ayush130305/8-Channel-PWM-Controller-with-SPI-Interface/pnr/pwm8_spi_core/pins.txt

miso_pn     S   250.70 (frame   950.70)
clk         S   508.80 (frame  1208.80)
sync_pn     S   800.70 (frame  1500.70)
rst_n       S  1058.80 (frame  1758.80)
sclk        S  1883.80 (frame  2583.80)
cs_n        S  2708.80 (frame  3408.80)
mosi        S  3258.80 (frame  3958.80)
pwm_pn[7]   N  1625.70 (frame  2325.70)
pwm_pn[6]   N  2175.70 (frame  2875.70)
pwm_pn[5]   N  3000.70 (frame  3700.70)
pwm_pn[0]   E   550.70 (frame  1250.70)
pwm_pn[1]   E  1075.70 (frame  1775.70)
pwm_pn[2]   E  1900.70 (frame  2600.70)
pwm_pn[3]   E  2725.70 (frame  3425.70)
pwm_pn[4]   E  3275.70 (frame  3975.70)
