ayush130305/8-Channel-PWM-Controller-with-SPI-Interface/docs/pwm8_spi.png

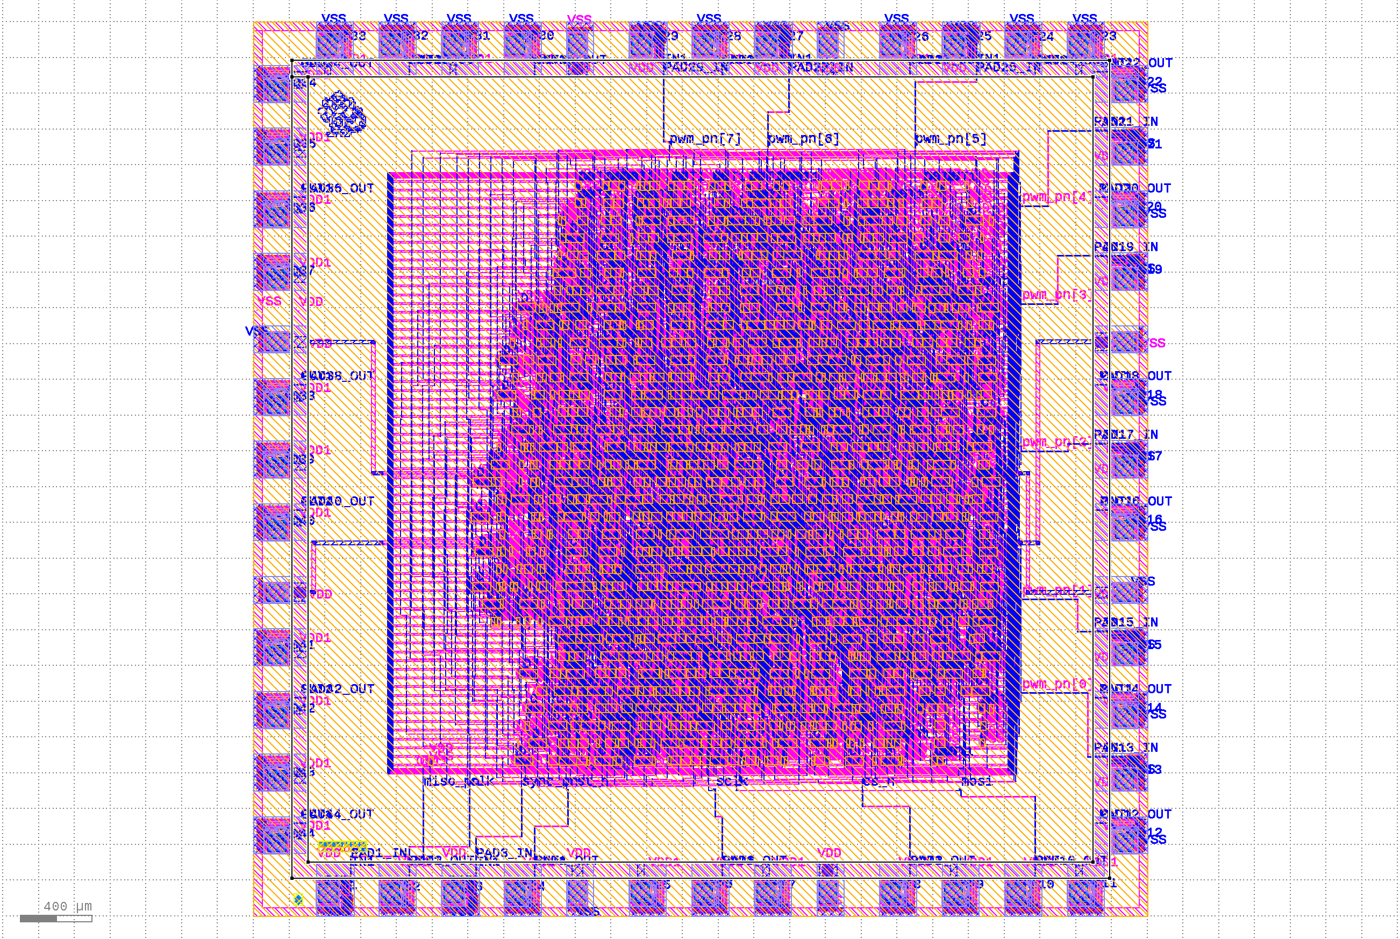
docs/pwm8_spi.png
