ayush130305/8-Channel-PWM-Controller-with-SPI-Interface/images/3_hierarchy/pwm8_spi_top.png

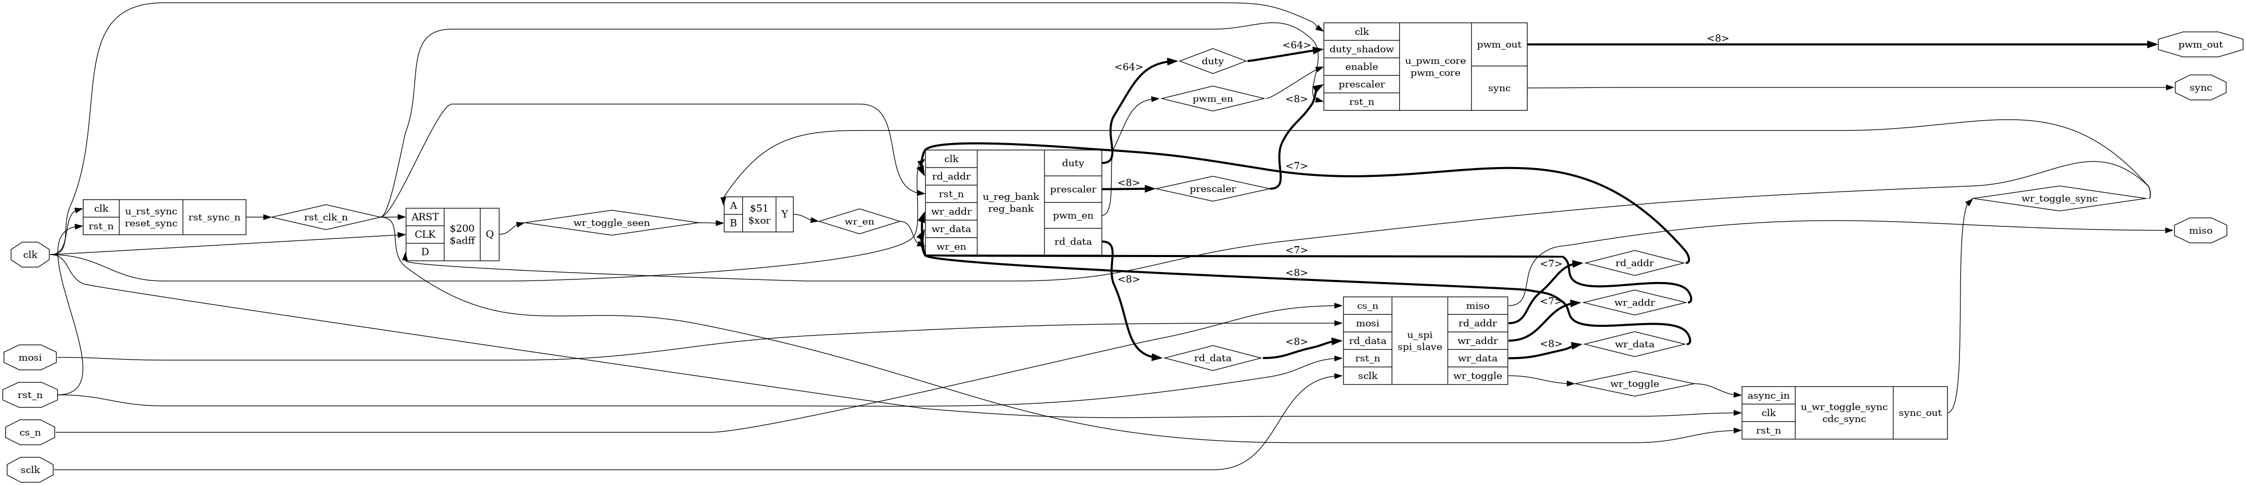
images/3_hierarchy/pwm8_spi_top.png
