ayush130305/8-Channel-PWM-Controller-with-SPI-Interface/images/4_rtl/pwm_core.png

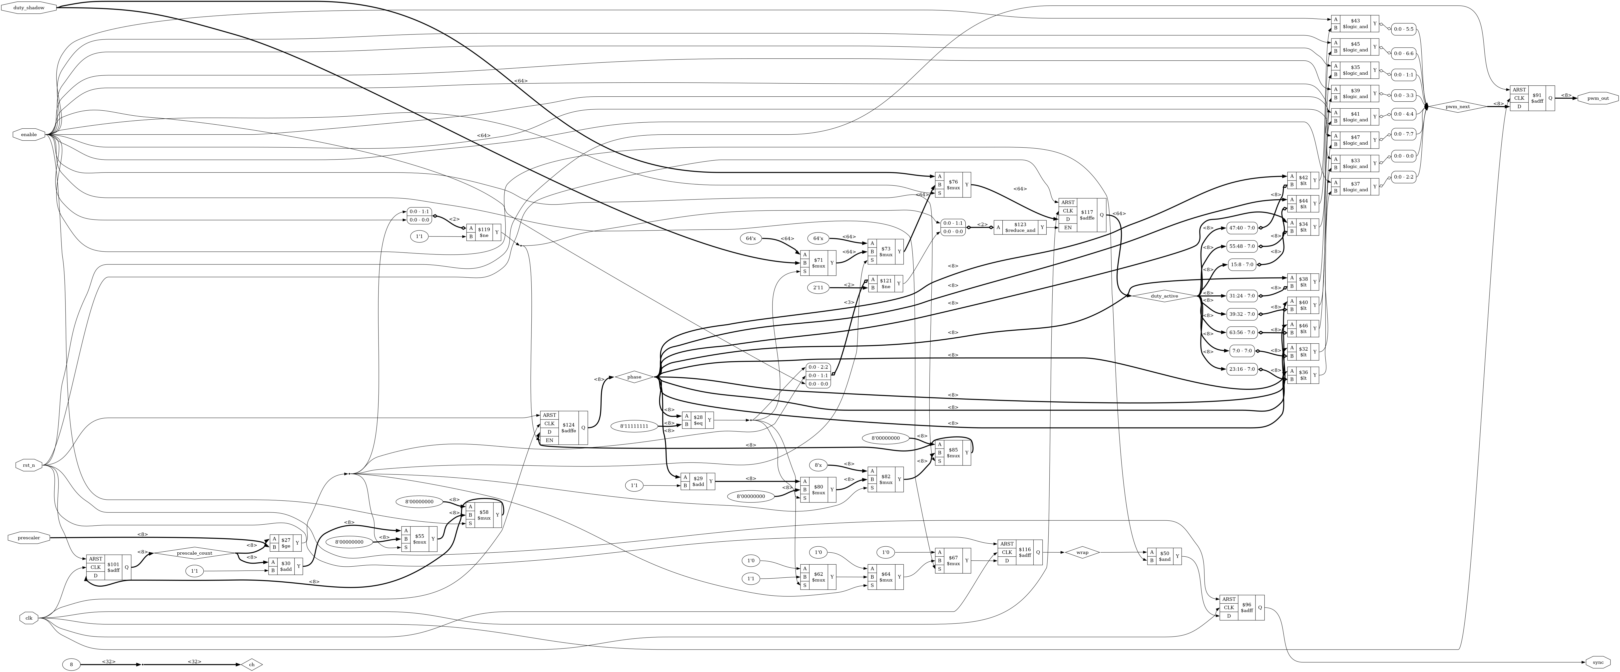
images/4_rtl/pwm_core.png
