ayush130305/8-Channel-PWM-Controller-with-SPI-Interface/images/4_rtl/reg_bank.png

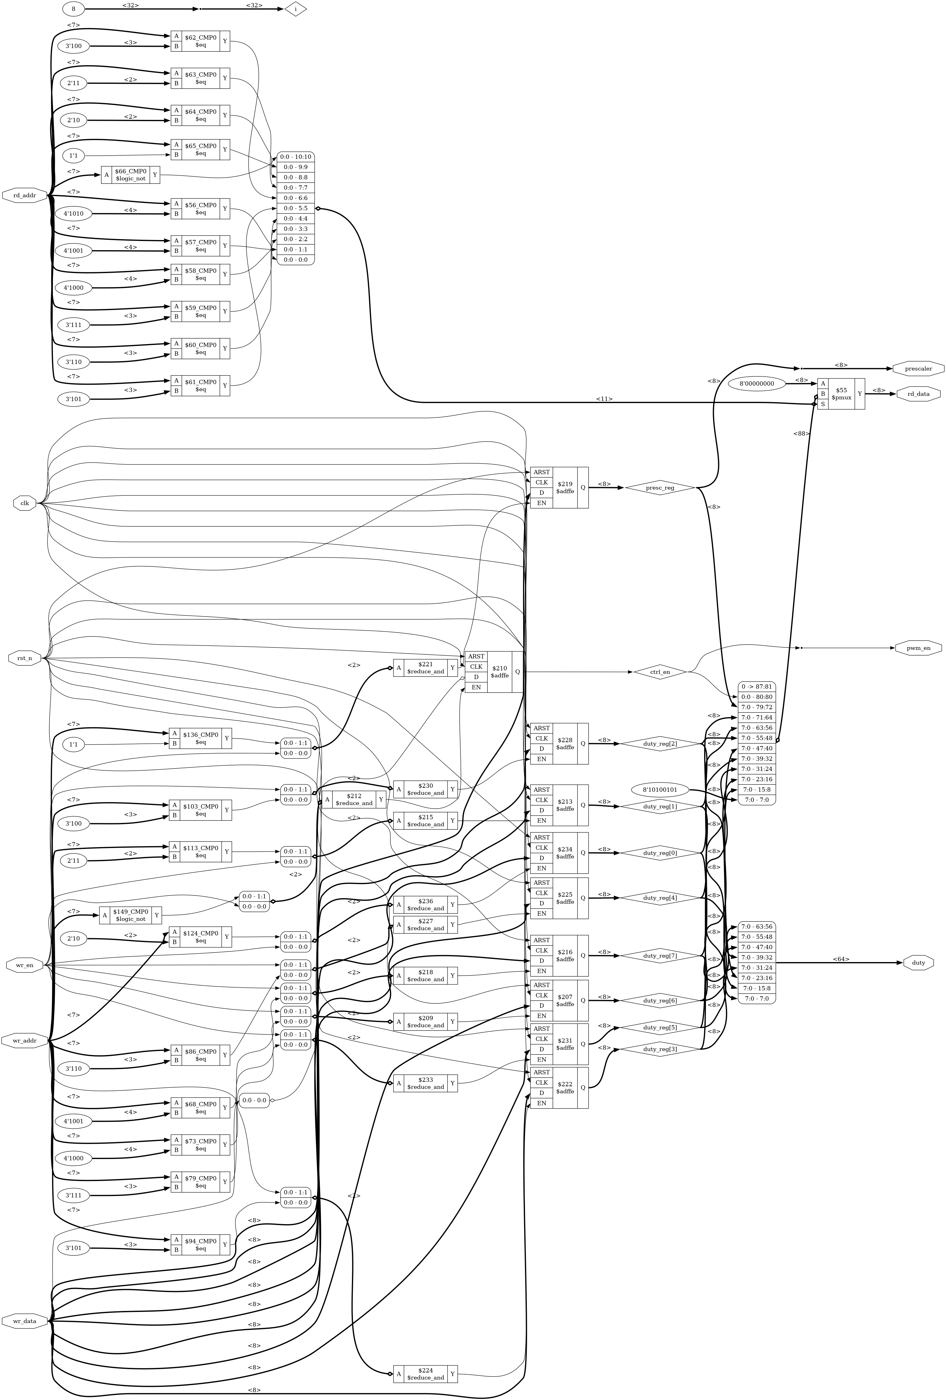
images/4_rtl/reg_bank.png
