ayush130305/8-Channel-PWM-Controller-with-SPI-Interface/images/4_rtl/reset_sync.png

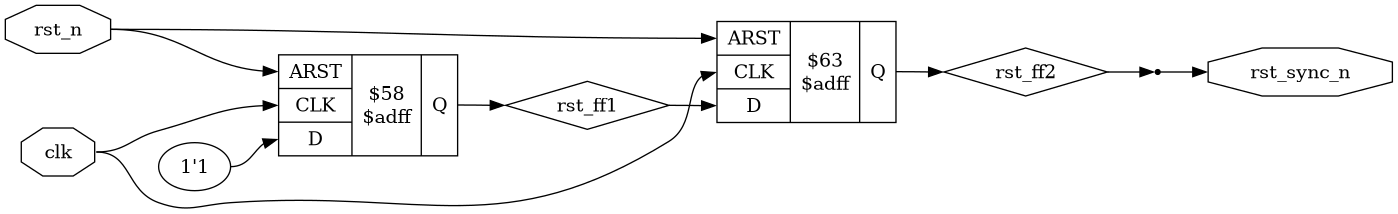
images/4_rtl/reset_sync.png
