ayush130305/8-Channel-PWM-Controller-with-SPI-Interface/images/4_rtl/spi_slave.png

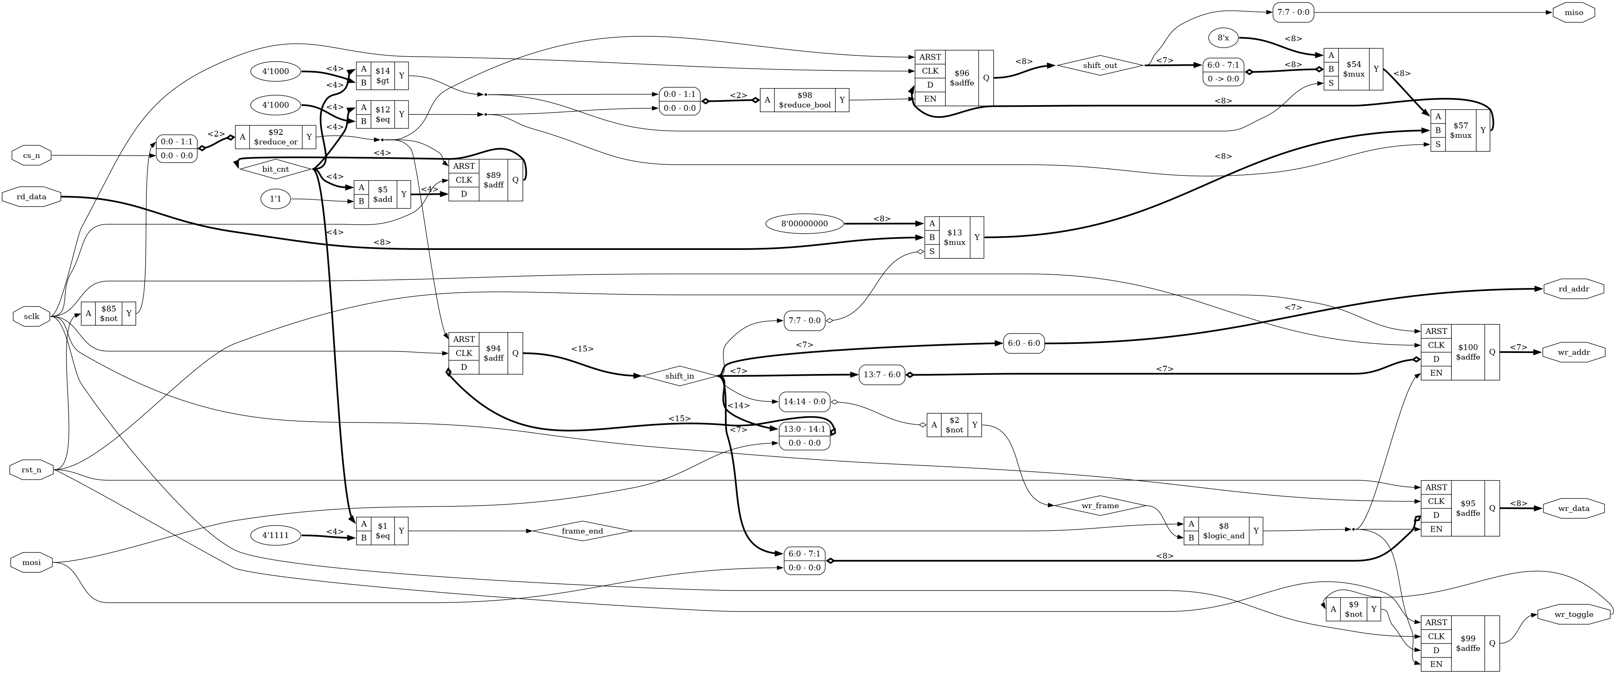
images/4_rtl/spi_slave.png
