ayush130305/8-Channel-PWM-Controller-with-SPI-Interface/images/5_gates/cdc_sync.png

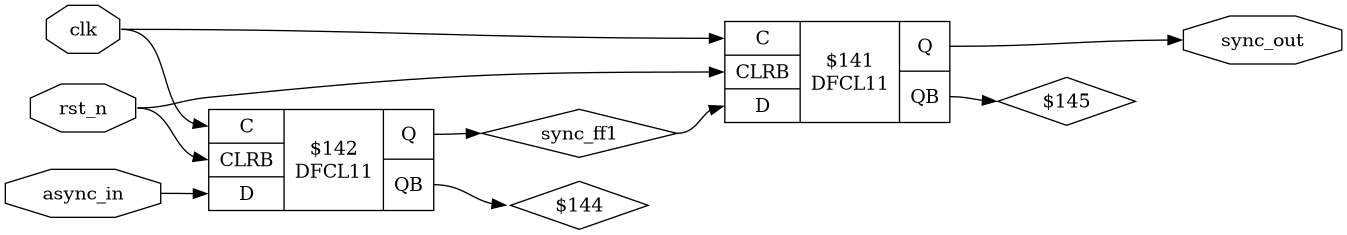
images/5_gates/cdc_sync.png
