ayush130305/8-Channel-PWM-Controller-with-SPI-Interface/images/5_gates/slices/reg_byte_slice.png

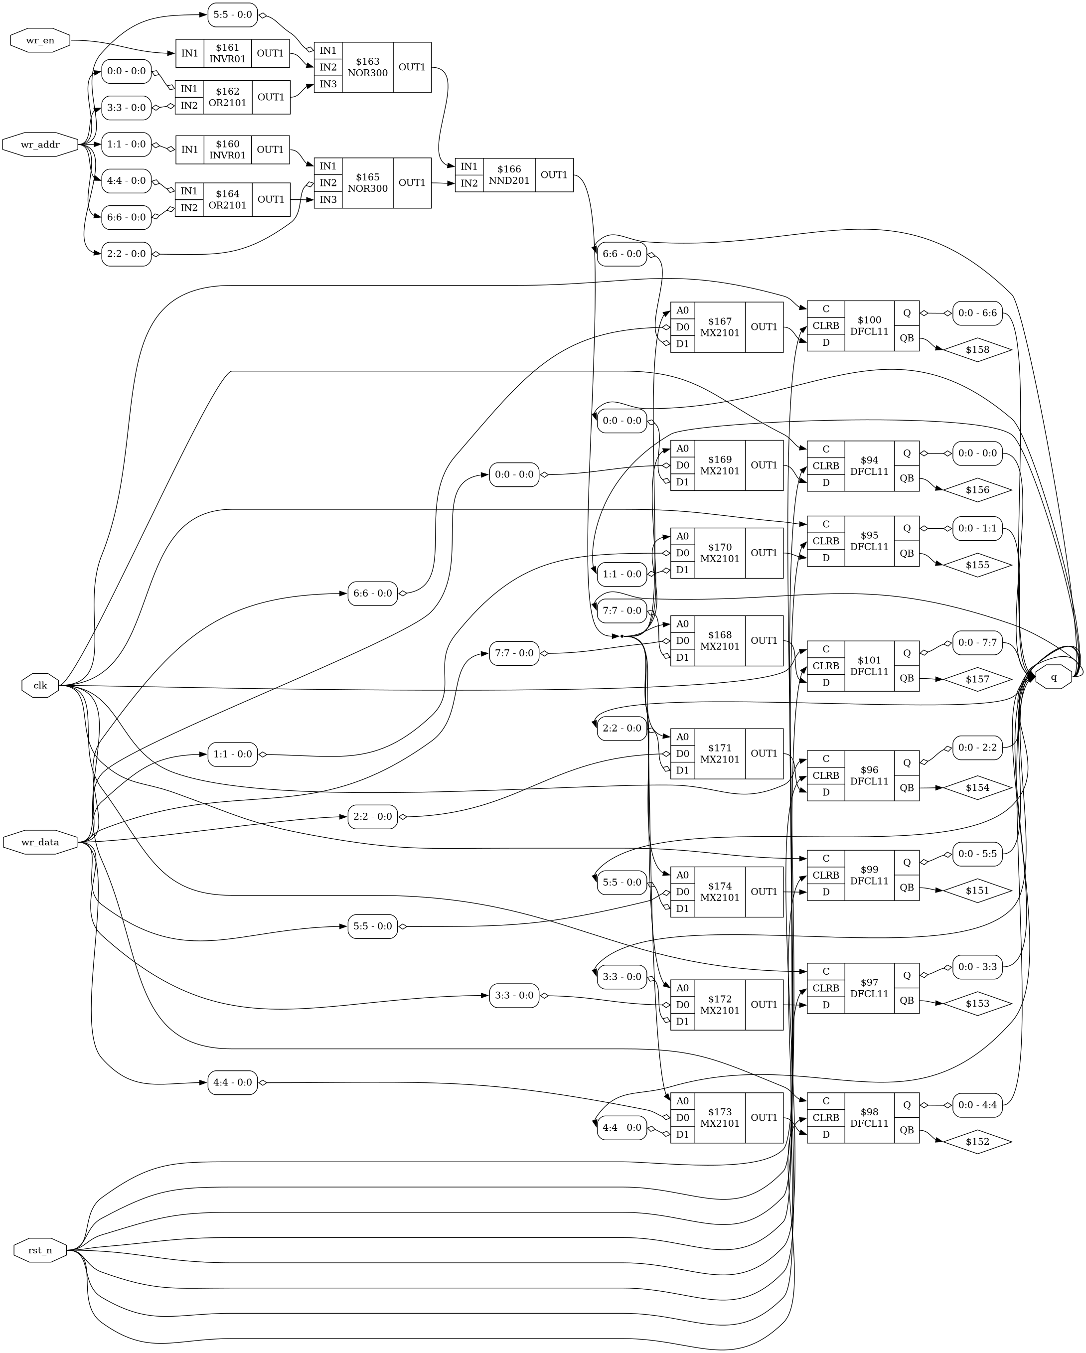
images/5_gates/slices/reg_byte_slice.png
