ayush130305/8-Channel-PWM-Controller-with-SPI-Interface/images/5_gates/spi_slave.png

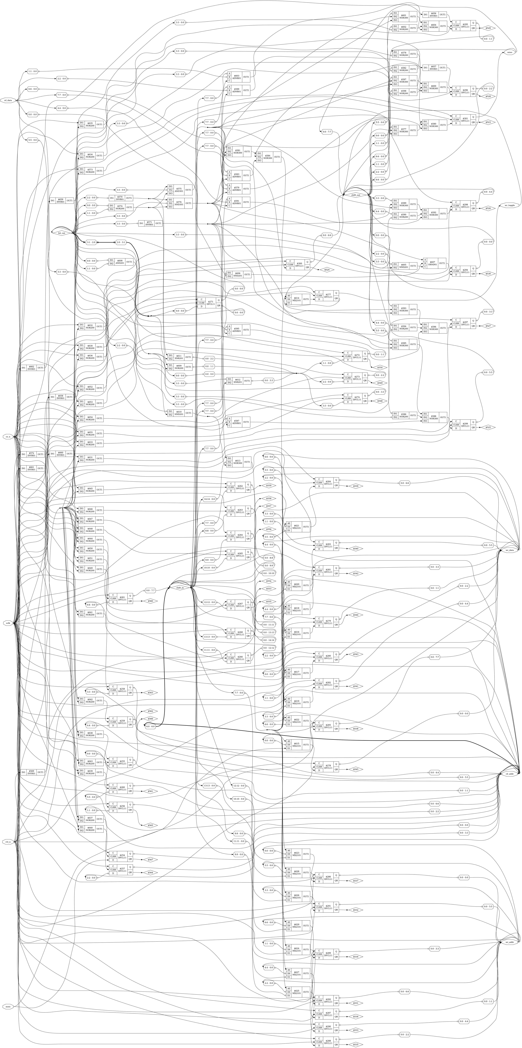
images/5_gates/spi_slave.png
