ayush130305/8-Channel-PWM-Controller-with-SPI-Interface/lvs/pwm8_spi_core.cir

* pwm8_spi_core from pnr/pwm8_spi_core/pwm8_spi_core_rt.v by flow/v2spice.py
.SUBCKT pwm8_spi_core clk cs_n miso_pn mosi rst_n sclk sync_pn pwm_pn[7] pwm_pn[6] pwm_pn[5] pwm_pn[4] pwm_pn[3] pwm_pn[2] pwm_pn[1] pwm_pn[0] VDD VSS
X_0840_ u_pwm.u_spi.shift_out[6] _0225_ VDD VSS INVR01
X_0841_ u_pwm.u_spi.shift_out[5] _0226_ VDD VSS INVR01
X_0842_ u_pwm.u_spi.shift_out[4] _0227_ VDD VSS INVR01
X_0843_ u_pwm.u_spi.shift_out[3] _0228_ VDD VSS INVR01
X_0844_ u_pwm.u_spi.shift_out[2] _0229_ VDD VSS INVR01
X_0845_ u_pwm.u_spi.shift_out[1] _0230_ VDD VSS INVR01
X_0846_ rst_n _0231_ VSS VDD INVR02
X_0847_ u_pwm.u_reg_bank.wr_addr[1] _0232_ VDD VSS INVR01
X_0848_ u_pwm.u_reg_bank.wr_addr[2] _0233_ VDD VSS INVR01
X_0849_ u_pwm.prescaler[7] _0234_ VDD VSS INVR01
X_0850_ u_pwm.u_pwm_core.prescale_count[6] _0235_ VDD VSS INVR01
X_0851_ u_pwm.prescaler[5] _0236_ VDD VSS INVR01
X_0852_ net354 _0237_ VDD VSS INVR01
X_0853_ u_pwm.u_pwm_core.prescale_count[3] _0238_ VDD VSS INVR01
X_0854_ u_pwm.u_pwm_core.prescale_count[2] _0239_ VDD VSS INVR01
X_0855_ u_pwm.u_pwm_core.prescale_count[1] _0240_ VDD VSS INVR01
X_0856_ u_pwm.u_pwm_core.prescale_count[0] _0241_ VDD VSS INVR01
X_0857_ net375 _0242_ VSS VDD INVR02
X_0858_ u_pwm.u_pwm_core.phase[1] _0243_ VSS VDD INVR03
X_0859_ u_pwm.u_pwm_core.phase[0] _0244_ VSS VDD INVR02
X_0860_ net74 _0245_ VSS VDD INVR04
X_0861_ u_pwm.u_pwm_core.phase[2] _0246_ VSS VDD INVR04
X_0862_ u_pwm.u_pwm_core.phase[5] _0247_ VSS VDD INVR04
X_0863_ u_pwm.u_pwm_core.phase[4] _0248_ VDD VSS INVR05
X_0864_ net73 _0249_ VSS VDD INVR03
X_0865_ u_pwm.u_pwm_core.phase[7] _0250_ VDD VSS INVR05
X_0866_ net128 _0251_ VSS VDD INVR02
X_0867_ u_pwm.u_pwm_core.duty_active[19] _0252_ VDD VSS INVR01
X_0868_ u_pwm.u_pwm_core.duty_active[46] _0253_ VDD VSS INVR01
X_0869_ u_pwm.u_pwm_core.duty_active[49] _0254_ VDD VSS INVR01
X_0870_ u_pwm.u_pwm_core.duty_active[62] _0255_ VDD VSS INVR01
X_0871_ net260 _0256_ VDD VSS INVR01
X_0872_ net258 _0257_ VDD VSS INVR01
X_0873_ u_pwm.rd_addr[3] _0258_ VDD VSS INVR01
X_0874_ clknet_2_3__leaf_sclk _0028_ VDD VSS INVR01
X_0875_ cs_n net447 _0041_ VDD VSS NOR200
X_0876_ miso u_pwm.u_spi.bit_cnt[3] _0259_ VDD VSS NOR200
X_0877_ u_pwm.u_spi.bit_cnt[0] u_pwm.u_spi.bit_cnt[1] _0260_ VDD VSS NOR200
X_0878_ u_pwm.u_spi.bit_cnt[2] net63 _0261_ VDD VSS NOR200
X_0879_ _0260_ _0261_ _0262_ VSS VDD NND201
X_0880_ _0262_ _0263_ VDD VSS INVR01
X_0881_ _0225_ net128 _0263_ _0264_ VDD VSS ADNR01
X_0882_ u_pwm.u_spi.shift_in[7] _0263_ _0265_ VSS VDD NND201
X_0883_ net262 _0256_ _0266_ VSS VDD NND201
X_0884_ net255 net256 u_pwm.rd_addr[6] _0267_ VDD VSS NOR300
X_0885_ _0257_ _0267_ _0268_ VSS VDD AND201
X_0886_ u_pwm.rd_addr[3] _0268_ _0269_ VSS VDD NND201
X_0887_ _0266_ _0269_ _0270_ VDD VSS NOR200
X_0888_ u_pwm.duty[63] net56 _0271_ VSS VDD NND201
X_0889_ net262 net260 _0272_ VSS VDD OR2101
X_0890_ _0269_ _0272_ _0273_ VDD VSS NOR201
X_0891_ net428 net54 _0274_ VSS VDD NND201
X_0892_ _0258_ _0268_ _0275_ VSS VDD NND201
X_0893_ net262 _0256_ _0276_ VSS VDD OR2101
X_0894_ _0275_ _0276_ _0277_ VDD VSS NOR201
X_0895_ u_pwm.duty[7] net53 _0278_ VSS VDD NND201
X_0896_ net262 net260 _0279_ VSS VDD NND201
X_0897_ _0275_ _0279_ _0280_ VDD VSS NOR200
X_0898_ u_pwm.duty[15] net52 _0281_ VSS VDD NND201
X_0899_ _0257_ u_pwm.rd_addr[3] _0282_ VDD VSS NOR200
X_0900_ _0267_ _0282_ _0283_ VSS VDD NND201
X_0901_ _0266_ _0283_ _0284_ VDD VSS NOR201
X_0902_ net339 net50 _0285_ VSS VDD NND201
X_0903_ _0269_ _0276_ _0286_ VDD VSS NOR201
X_0904_ _0279_ _0283_ _0287_ VDD VSS NOR201
X_0905_ net359 net48 _0286_ _0288_ VDD VSS ADNR01
X_0906_ _0266_ _0275_ _0289_ VDD VSS NOR200
X_0907_ _0234_ _0266_ _0275_ _0290_ VDD VSS NOR300
X_0908_ _0276_ _0283_ _0291_ VDD VSS NOR201
X_0909_ net294 net45 _0292_ VSS VDD NND201
X_0910_ _0272_ _0283_ _0293_ VDD VSS NOR201
X_0911_ u_pwm.duty[23] net44 _0294_ VSS VDD NND201
X_0912_ _0278_ _0285_ _0295_ VSS VDD NND201
X_0913_ _0271_ _0274_ _0281_ _0294_ _0292_ _0288_ _0296_ VSS VDD NND601
X_0914_ _0290_ _0295_ _0296_ _0297_ VDD VSS NOR300
X_0915_ _0265_ _0297_ _0298_ VDD VSS NOR200
X_0916_ _0264_ _0298_ _0299_ VDD VSS NOR200
X_0917_ _0259_ _0299_ _0191_ VDD VSS NOR200
X_0918_ _0226_ net128 _0263_ _0300_ VDD VSS ADNR01
X_0919_ u_pwm.duty[54] net54 _0301_ VSS VDD NND201
X_0920_ net326 net53 _0302_ VSS VDD NND201
X_0921_ _0301_ _0302_ _0303_ VSS VDD NND201
X_0922_ u_pwm.duty[14] net51 _0303_ _0304_ VDD VSS ADNR01
X_0923_ net361 net48 _0305_ VSS VDD NND201
X_0924_ net281 net44 _0306_ VSS VDD NND201
X_0925_ _0305_ _0306_ _0307_ VSS VDD NND201
X_0926_ u_pwm.duty[38] net46 _0308_ VSS VDD NND201
X_0927_ net341 net50 _0309_ VSS VDD NND201
X_0928_ _0308_ _0309_ _0310_ VSS VDD NND201
X_0929_ u_pwm.prescaler[6] _0289_ _0311_ VSS VDD NND201
X_0930_ net265 net56 _0312_ VSS VDD NND201
X_0931_ _0311_ _0312_ _0313_ VSS VDD NND201
X_0932_ _0307_ _0310_ _0313_ _0314_ VDD VSS NOR300
X_0933_ _0304_ _0314_ _0265_ _0315_ VDD VSS ADNR01
X_0934_ _0300_ _0315_ _0316_ VDD VSS NOR200
X_0935_ _0225_ _0251_ _0316_ _0190_ VDD VSS ADNR01
X_0936_ _0227_ net128 _0263_ _0317_ VDD VSS ADNR01
X_0937_ u_pwm.duty[53] net54 _0318_ VSS VDD NND201
X_0938_ net314 net52 _0319_ VSS VDD NND201
X_0939_ u_pwm.duty[45] net48 _0320_ VSS VDD NND201
X_0940_ net298 net45 _0321_ VSS VDD NND201
X_0941_ net283 net44 _0322_ VSS VDD NND201
X_0942_ u_pwm.prescaler[5] net47 _0323_ VSS VDD NND201
X_0943_ net328 net53 _0284_ net344 _0324_ VDD VSS AOI401
X_0944_ _0323_ _0324_ _0325_ VSS VDD NND201
X_0945_ u_pwm.duty[61] net56 _0286_ _0326_ VDD VSS ADNR01
X_0946_ _0318_ _0319_ _0320_ _0326_ _0322_ _0321_ _0327_ VSS VDD NND601
X_0947_ _0325_ _0327_ _0328_ VDD VSS NOR200
X_0948_ _0265_ _0328_ _0329_ VDD VSS NOR200
X_0949_ _0317_ _0329_ _0330_ VDD VSS NOR200
X_0950_ _0226_ _0251_ _0330_ _0189_ VDD VSS ADNR01
X_0951_ _0228_ net128 _0263_ _0331_ VDD VSS ADNR01
X_0952_ u_pwm.prescaler[4] net47 _0332_ VSS VDD NND201
X_0953_ net330 net53 _0333_ VSS VDD NND201
X_0954_ net285 net44 _0334_ VSS VDD NND201
X_0955_ u_pwm.duty[44] net49 _0335_ VSS VDD NND201
X_0956_ net300 net45 _0336_ VSS VDD NND201
X_0957_ u_pwm.duty[52] net54 _0337_ VSS VDD NND201
X_0958_ u_pwm.duty[60] net56 _0338_ VSS VDD NND201
X_0959_ net316 net52 net50 net345 _0339_ VDD VSS AOI401
X_0960_ _0335_ _0339_ _0340_ VSS VDD NND201
X_0961_ _0332_ _0333_ _0334_ _0338_ _0337_ _0336_ _0341_ VSS VDD NND601
X_0962_ _0340_ _0341_ _0342_ VDD VSS NOR200
X_0963_ _0265_ _0342_ _0343_ VDD VSS NOR200
X_0964_ _0331_ _0343_ _0344_ VDD VSS NOR200
X_0965_ _0227_ _0251_ _0344_ _0188_ VDD VSS ADNR01
X_0966_ _0229_ net128 _0263_ _0345_ VDD VSS ADNR01
X_0967_ u_pwm.prescaler[3] net47 _0346_ VSS VDD NND201
X_0968_ net332 net53 _0347_ VSS VDD NND201
X_0969_ net286 net44 _0348_ VSS VDD NND201
X_0970_ net367 net49 _0349_ VSS VDD NND201
X_0971_ net302 net45 _0350_ VSS VDD NND201
X_0972_ u_pwm.duty[51] net54 _0351_ VSS VDD NND201
X_0973_ u_pwm.duty[59] net56 _0352_ VSS VDD NND201
X_0974_ net317 net51 _0284_ net346 _0353_ VDD VSS AOI401
X_0975_ _0349_ _0353_ _0354_ VSS VDD NND201
X_0976_ _0346_ _0347_ _0348_ _0352_ _0351_ _0350_ _0355_ VSS VDD NND601
X_0977_ _0354_ _0355_ _0356_ VDD VSS NOR200
X_0978_ _0265_ _0356_ _0357_ VDD VSS NOR200
X_0979_ _0345_ _0357_ _0358_ VDD VSS NOR200
X_0980_ _0228_ net63 _0358_ _0187_ VDD VSS ADNR01
X_0981_ _0230_ u_pwm.u_spi.bit_cnt[3] _0263_ _0359_ VDD VSS ADNR01
X_0982_ u_pwm.duty[50] net55 _0360_ VSS VDD NND201
X_0983_ net319 net51 _0361_ VSS VDD NND201
X_0984_ net369 net48 _0362_ VSS VDD NND201
X_0985_ net304 net45 _0363_ VSS VDD NND201
X_0986_ u_pwm.duty[18] _0293_ _0364_ VSS VDD NND201
X_0987_ u_pwm.prescaler[2] net47 _0365_ VSS VDD NND201
X_0988_ net334 _0277_ _0284_ net348 _0366_ VDD VSS AOI401
X_0989_ _0365_ _0366_ _0367_ VSS VDD NND201
X_0990_ u_pwm.duty[58] net56 _0286_ _0368_ VDD VSS ADNR01
X_0991_ _0360_ _0361_ _0362_ _0368_ _0364_ _0363_ _0369_ VSS VDD NND601
X_0992_ _0367_ _0369_ _0370_ VDD VSS NOR200
X_0993_ _0265_ _0370_ _0371_ VDD VSS NOR200
X_0994_ _0359_ _0371_ _0372_ VDD VSS NOR200
X_0995_ _0229_ _0251_ _0372_ _0186_ VDD VSS ADNR01
X_0996_ u_pwm.u_spi.shift_out[0] net63 _0373_ VSS VDD OR2101
X_0997_ u_pwm.duty[49] net55 _0374_ VSS VDD NND201
X_0998_ net335 _0277_ _0375_ VSS VDD NND201
X_0999_ u_pwm.duty[33] _0291_ _0376_ VSS VDD NND201
X_1000_ net350 net50 _0377_ VSS VDD NND201
X_1001_ net370 _0287_ _0378_ VSS VDD NND201
X_1002_ u_pwm.duty[57] _0270_ _0379_ VSS VDD NND201
X_1003_ u_pwm.prescaler[1] net47 _0380_ VSS VDD NND201
X_1004_ net321 _0280_ _0293_ u_pwm.duty[17] _0381_ VDD VSS AOI401
X_1005_ _0379_ _0381_ _0382_ VSS VDD NND201
X_1006_ _0374_ _0375_ _0376_ _0380_ _0378_ _0377_ _0383_ VSS VDD NND601
X_1007_ _0382_ _0383_ _0384_ VDD VSS NOR200
X_1008_ _0265_ _0384_ _0385_ VDD VSS NOR200
X_1009_ _0262_ _0373_ _0385_ _0386_ VDD VSS ADNR01
X_1010_ _0230_ net63 _0386_ _0185_ VDD VSS ADNR01
X_1011_ u_pwm.u_spi.shift_out[0] net63 _0387_ VSS VDD NND201
X_1012_ u_pwm.duty[48] net55 _0289_ u_pwm.prescaler[0] _0388_ VDD VSS AOI401
X_1013_ u_pwm.duty[56] _0270_ _0277_ u_pwm.duty[0] _0389_ VDD VSS AOI401
X_1014_ _0388_ _0389_ _0390_ VSS VDD NND201
X_1015_ net351 net50 net49 net371 _0391_ VDD VSS AOI401
X_1016_ net72 _0272_ _0275_ _0392_ VDD VSS NOR300
X_1017_ u_pwm.duty[32] net46 _0392_ _0393_ VDD VSS ADNR01
X_1018_ _0391_ _0393_ _0394_ VSS VDD NND201
X_1019_ net323 net52 _0395_ VSS VDD NND201
X_1020_ u_pwm.duty[16] _0293_ _0286_ _0396_ VDD VSS ADNR01
X_1021_ _0395_ _0396_ _0397_ VSS VDD NND201
X_1022_ _0390_ _0394_ _0397_ _0398_ VDD VSS NOR300
X_1023_ _0265_ _0398_ _0387_ _0184_ VSS VDD ORND01
X_1024_ net71 u_pwm.u_pwm_core.duty_active[1] u_pwm.u_pwm_core.duty_active[0] net70 _0399_ VDD VSS AOI401
X_1025_ net68 u_pwm.u_pwm_core.duty_active[2] _0400_ VDD VSS NOR200
X_1026_ net71 u_pwm.u_pwm_core.duty_active[1] _0401_ VDD VSS NOR200
X_1027_ _0399_ _0400_ _0401_ _0402_ VDD VSS NOR300
X_1028_ net68 u_pwm.u_pwm_core.duty_active[2] _0403_ VSS VDD NND201
X_1029_ net69 net425 _0404_ VSS VDD NND201
X_1030_ _0403_ _0404_ _0405_ VSS VDD NND201
X_1031_ _0402_ _0405_ _0406_ VDD VSS NOR200
X_1032_ net66 net424 _0407_ VDD VSS NOR200
X_1033_ net69 u_pwm.u_pwm_core.duty_active[3] _0408_ VDD VSS NOR200
X_1034_ _0406_ _0407_ _0408_ _0409_ VDD VSS NOR300
X_1035_ net67 u_pwm.u_pwm_core.duty_active[5] _0410_ VSS VDD NND201
X_1036_ net66 u_pwm.u_pwm_core.duty_active[4] _0411_ VSS VDD NND201
X_1037_ _0410_ _0411_ _0412_ VSS VDD NND201
X_1038_ _0409_ _0412_ _0413_ VDD VSS NOR200
X_1039_ net67 u_pwm.u_pwm_core.duty_active[5] _0414_ VDD VSS NOR200
X_1040_ net65 u_pwm.u_pwm_core.duty_active[6] _0415_ VDD VSS NOR200
X_1041_ _0413_ _0414_ _0415_ _0416_ VDD VSS NOR300
X_1042_ net64 u_pwm.u_pwm_core.duty_active[7] _0417_ VSS VDD NND201
X_1043_ net65 u_pwm.u_pwm_core.duty_active[6] _0416_ _0418_ VDD VSS ADNR01
X_1044_ net64 u_pwm.u_pwm_core.duty_active[7] net372 _0419_ VSS VDD ORND01
X_1045_ _0417_ _0418_ _0419_ u_pwm.u_pwm_core.pwm_next[0] VDD VSS ADNR01
X_1046_ net69 u_pwm.u_pwm_core.duty_active[11] _0420_ VSS VDD NND201
X_1047_ net68 u_pwm.u_pwm_core.duty_active[10] _0421_ VDD VSS NOR200
X_1048_ net68 u_pwm.u_pwm_core.duty_active[10] _0422_ VSS VDD NND201
X_1049_ net71 u_pwm.u_pwm_core.duty_active[9] u_pwm.u_pwm_core.duty_active[8] net70 _0423_ VDD VSS AOI401
X_1050_ net71 u_pwm.u_pwm_core.duty_active[9] _0424_ VDD VSS NOR200
X_1051_ _0421_ _0423_ _0424_ _0425_ VDD VSS NOR300
X_1052_ _0420_ _0422_ _0426_ VSS VDD NND201
X_1053_ _0425_ _0426_ _0427_ VDD VSS NOR200
X_1054_ net66 net417 _0428_ VDD VSS NOR200
X_1055_ net69 u_pwm.u_pwm_core.duty_active[11] _0429_ VDD VSS NOR200
X_1056_ _0427_ _0428_ _0429_ _0430_ VDD VSS NOR300
X_1057_ net67 net416 _0431_ VSS VDD NND201
X_1058_ net66 u_pwm.u_pwm_core.duty_active[12] _0432_ VSS VDD NND201
X_1059_ _0431_ _0432_ _0433_ VSS VDD NND201
X_1060_ _0430_ _0433_ _0434_ VDD VSS NOR200
X_1061_ net65 u_pwm.u_pwm_core.duty_active[14] _0435_ VDD VSS NOR200
X_1062_ net67 u_pwm.u_pwm_core.duty_active[13] _0436_ VDD VSS NOR200
X_1063_ _0434_ _0435_ _0436_ _0437_ VDD VSS NOR300
X_1064_ net64 u_pwm.u_pwm_core.duty_active[15] _0438_ VSS VDD NND201
X_1065_ net65 u_pwm.u_pwm_core.duty_active[14] _0437_ _0439_ VDD VSS ADNR01
X_1066_ net64 u_pwm.u_pwm_core.duty_active[15] net372 _0440_ VSS VDD ORND01
X_1067_ _0438_ _0439_ _0440_ u_pwm.u_pwm_core.pwm_next[1] VDD VSS ADNR01
X_1068_ _0246_ u_pwm.u_pwm_core.duty_active[18] _0441_ VDD VSS NOR200
X_1069_ _0243_ u_pwm.u_pwm_core.duty_active[17] u_pwm.u_pwm_core.duty_active[16] net70 _0442_ VDD VSS AOI401
X_1070_ _0243_ u_pwm.u_pwm_core.duty_active[17] _0443_ VDD VSS NOR200
X_1071_ _0441_ _0442_ _0443_ _0444_ VDD VSS NOR300
X_1072_ _0246_ u_pwm.u_pwm_core.duty_active[18] _0444_ _0445_ VDD VSS ADNR01
X_1073_ net74 _0252_ _0445_ _0446_ VSS VDD ORND01
X_1074_ net66 u_pwm.u_pwm_core.duty_active[20] _0447_ VDD VSS NOR200
X_1075_ net74 _0252_ _0447_ _0448_ VDD VSS ADNR01
X_1076_ net67 net410 _0449_ VSS VDD NND201
X_1077_ net66 u_pwm.u_pwm_core.duty_active[20] _0450_ VSS VDD NND201
X_1078_ _0449_ _0450_ _0451_ VSS VDD NND201
X_1079_ _0446_ _0448_ _0451_ _0452_ VDD VSS ADNR01
X_1080_ net67 u_pwm.u_pwm_core.duty_active[21] _0453_ VDD VSS NOR200
X_1081_ net65 u_pwm.u_pwm_core.duty_active[22] _0454_ VDD VSS NOR200
X_1082_ _0452_ _0453_ _0454_ _0455_ VDD VSS NOR300
X_1083_ net64 u_pwm.u_pwm_core.duty_active[23] _0456_ VSS VDD NND201
X_1084_ net65 u_pwm.u_pwm_core.duty_active[22] _0455_ _0457_ VDD VSS ADNR01
X_1085_ net64 u_pwm.u_pwm_core.duty_active[23] net372 _0458_ VSS VDD ORND01
X_1086_ _0456_ _0457_ _0458_ u_pwm.u_pwm_core.pwm_next[2] VDD VSS ADNR01
X_1087_ net68 u_pwm.u_pwm_core.duty_active[26] _0459_ VDD VSS NOR200
X_1088_ net71 u_pwm.u_pwm_core.duty_active[25] _0460_ VDD VSS NOR200
X_1089_ net71 u_pwm.u_pwm_core.duty_active[25] u_pwm.u_pwm_core.duty_active[24] net70 _0461_ VDD VSS AOI401
X_1090_ _0459_ _0460_ _0461_ _0462_ VDD VSS NOR300
X_1091_ net68 u_pwm.u_pwm_core.duty_active[26] _0463_ VSS VDD NND201
X_1092_ net69 u_pwm.u_pwm_core.duty_active[27] _0464_ VSS VDD NND201
X_1093_ _0463_ _0464_ _0465_ VSS VDD NND201
X_1094_ _0462_ _0465_ _0466_ VDD VSS NOR200
X_1095_ net66 net404 _0467_ VDD VSS NOR200
X_1096_ net69 u_pwm.u_pwm_core.duty_active[27] _0468_ VDD VSS NOR200
X_1097_ _0466_ _0467_ _0468_ _0469_ VDD VSS NOR300
X_1098_ net67 u_pwm.u_pwm_core.duty_active[29] _0470_ VSS VDD NND201
X_1099_ net66 u_pwm.u_pwm_core.duty_active[28] _0471_ VSS VDD NND201
X_1100_ _0470_ _0471_ _0472_ VSS VDD NND201
X_1101_ _0469_ _0472_ _0473_ VDD VSS NOR200
X_1102_ net67 u_pwm.u_pwm_core.duty_active[29] _0474_ VDD VSS NOR200
X_1103_ net65 u_pwm.u_pwm_core.duty_active[30] _0475_ VDD VSS NOR200
X_1104_ _0473_ _0474_ _0475_ _0476_ VDD VSS NOR300
X_1105_ net64 u_pwm.u_pwm_core.duty_active[31] _0477_ VSS VDD NND201
X_1106_ net65 u_pwm.u_pwm_core.duty_active[30] _0476_ _0478_ VDD VSS ADNR01
X_1107_ net64 u_pwm.u_pwm_core.duty_active[31] net372 _0479_ VSS VDD ORND01
X_1108_ _0477_ _0478_ _0479_ u_pwm.u_pwm_core.pwm_next[3] VDD VSS ADNR01
X_1109_ net69 net398 _0480_ VSS VDD NND201
X_1110_ net68 net399 _0481_ VDD VSS NOR200
X_1111_ net68 u_pwm.u_pwm_core.duty_active[34] _0482_ VSS VDD NND201
X_1112_ net71 u_pwm.u_pwm_core.duty_active[33] u_pwm.u_pwm_core.duty_active[32] net70 _0483_ VDD VSS AOI401
X_1113_ net71 u_pwm.u_pwm_core.duty_active[33] _0484_ VDD VSS NOR200
X_1114_ _0480_ _0482_ _0485_ VSS VDD NND201
X_1115_ _0481_ _0483_ _0484_ _0486_ VDD VSS NOR300
X_1116_ _0485_ _0486_ _0487_ VDD VSS NOR200
X_1117_ net69 u_pwm.u_pwm_core.duty_active[35] _0488_ VDD VSS NOR200
X_1118_ net66 net397 _0489_ VDD VSS NOR200
X_1119_ _0487_ _0488_ _0489_ _0490_ VDD VSS NOR300
X_1120_ net67 u_pwm.u_pwm_core.duty_active[37] _0491_ VSS VDD NND201
X_1121_ _0248_ u_pwm.u_pwm_core.duty_active[36] _0492_ VSS VDD NND201
X_1122_ _0491_ _0492_ _0493_ VSS VDD NND201
X_1123_ _0490_ _0493_ _0494_ VDD VSS NOR200
X_1124_ _0249_ u_pwm.u_pwm_core.duty_active[38] _0495_ VDD VSS NOR200
X_1125_ net67 u_pwm.u_pwm_core.duty_active[37] _0496_ VDD VSS NOR200
X_1126_ _0494_ _0495_ _0496_ _0497_ VDD VSS NOR300
X_1127_ net64 u_pwm.u_pwm_core.duty_active[39] _0498_ VSS VDD NND201
X_1128_ _0249_ u_pwm.u_pwm_core.duty_active[38] _0497_ _0499_ VDD VSS ADNR01
X_1129_ net64 u_pwm.u_pwm_core.duty_active[39] net374 _0500_ VSS VDD ORND01
X_1130_ _0498_ _0499_ _0500_ u_pwm.u_pwm_core.pwm_next[4] VDD VSS ADNR01
X_1131_ net68 u_pwm.u_pwm_core.duty_active[42] _0501_ VDD VSS NOR200
X_1132_ net71 u_pwm.u_pwm_core.duty_active[41] _0502_ VDD VSS NOR200
X_1133_ net71 u_pwm.u_pwm_core.duty_active[41] u_pwm.u_pwm_core.duty_active[40] net70 _0503_ VDD VSS AOI401
X_1134_ _0501_ _0502_ _0503_ _0504_ VDD VSS NOR300
X_1135_ net68 u_pwm.u_pwm_core.duty_active[42] _0505_ VSS VDD NND201
X_1136_ net69 u_pwm.u_pwm_core.duty_active[43] _0506_ VSS VDD NND201
X_1137_ _0505_ _0506_ _0507_ VSS VDD NND201
X_1138_ _0504_ _0507_ _0508_ VDD VSS NOR200
X_1139_ net66 u_pwm.u_pwm_core.duty_active[44] _0509_ VDD VSS NOR200
X_1140_ net69 u_pwm.u_pwm_core.duty_active[43] _0510_ VDD VSS NOR200
X_1141_ _0508_ _0509_ _0510_ _0511_ VDD VSS NOR300
X_1142_ _0247_ u_pwm.u_pwm_core.duty_active[45] _0512_ VSS VDD NND201
X_1143_ net66 u_pwm.u_pwm_core.duty_active[44] _0513_ VSS VDD NND201
X_1144_ _0512_ _0513_ _0514_ VSS VDD NND201
X_1145_ _0247_ u_pwm.u_pwm_core.duty_active[45] _0515_ VDD VSS NOR200
X_1146_ net73 _0253_ _0515_ _0516_ VDD VSS ADNR01
X_1147_ _0511_ _0514_ _0516_ _0517_ VSS VDD ORND01
X_1148_ net73 _0253_ _0518_ VDD VSS NOR200
X_1149_ _0250_ u_pwm.u_pwm_core.duty_active[47] _0518_ _0519_ VDD VSS ADNR01
X_1150_ _0250_ u_pwm.u_pwm_core.duty_active[47] net374 _0520_ VSS VDD ORND01
X_1151_ _0517_ _0519_ _0520_ u_pwm.u_pwm_core.pwm_next[5] VDD VSS ADNR01
X_1152_ _0250_ u_pwm.u_pwm_core.duty_active[55] _0521_ VSS VDD NND201
X_1153_ _0245_ u_pwm.u_pwm_core.duty_active[51] _0522_ VDD VSS NOR200
X_1154_ _0246_ net386 _0523_ VDD VSS NOR200
X_1155_ _0244_ net387 _0524_ VSS VDD NND201
X_1156_ u_pwm.u_pwm_core.phase[1] _0254_ _0524_ _0525_ VSS VDD ORND01
X_1157_ u_pwm.u_pwm_core.phase[1] _0254_ _0523_ _0526_ VDD VSS ADNR01
X_1158_ _0246_ net386 _0525_ _0526_ _0527_ VDD VSS AOI401
X_1159_ _0248_ net385 u_pwm.u_pwm_core.duty_active[51] _0245_ _0528_ VDD VSS AOI401
X_1160_ _0522_ _0527_ _0528_ _0529_ VSS VDD ORND01
X_1161_ _0248_ u_pwm.u_pwm_core.duty_active[52] _0530_ VDD VSS NOR200
X_1162_ _0247_ u_pwm.u_pwm_core.duty_active[53] _0529_ _0531_ VSS VDD ORND01
X_1163_ _0249_ u_pwm.u_pwm_core.duty_active[54] u_pwm.u_pwm_core.duty_active[53] _0247_ _0532_ VDD VSS AOI401
X_1164_ _0530_ _0531_ _0532_ _0533_ VSS VDD ORND01
X_1165_ _0249_ u_pwm.u_pwm_core.duty_active[54] _0533_ _0534_ VSS VDD ORND01
X_1166_ _0250_ u_pwm.u_pwm_core.duty_active[55] net374 _0535_ VSS VDD ORND01
X_1167_ _0521_ _0534_ _0535_ u_pwm.u_pwm_core.pwm_next[6] VDD VSS ADNR01
X_1168_ _0246_ u_pwm.u_pwm_core.duty_active[58] _0536_ VDD VSS NOR200
X_1169_ _0243_ u_pwm.u_pwm_core.duty_active[57] _0537_ VDD VSS NOR200
X_1170_ _0243_ u_pwm.u_pwm_core.duty_active[57] u_pwm.u_pwm_core.duty_active[56] _0244_ _0538_ VDD VSS AOI401
X_1171_ _0536_ _0537_ _0538_ _0539_ VDD VSS NOR300
X_1172_ _0246_ u_pwm.u_pwm_core.duty_active[58] _0540_ VSS VDD NND201
X_1173_ _0245_ net380 _0541_ VSS VDD NND201
X_1174_ _0540_ _0541_ _0542_ VSS VDD NND201
X_1175_ _0539_ _0542_ _0543_ VDD VSS NOR200
X_1176_ _0248_ u_pwm.u_pwm_core.duty_active[60] _0544_ VDD VSS NOR200
X_1177_ _0245_ u_pwm.u_pwm_core.duty_active[59] _0545_ VDD VSS NOR200
X_1178_ _0543_ _0544_ _0545_ _0546_ VDD VSS NOR300
X_1179_ _0247_ u_pwm.u_pwm_core.duty_active[61] _0547_ VSS VDD NND201
X_1180_ _0248_ u_pwm.u_pwm_core.duty_active[60] _0548_ VSS VDD NND201
X_1181_ _0547_ _0548_ _0549_ VSS VDD NND201
X_1182_ _0247_ u_pwm.u_pwm_core.duty_active[61] _0550_ VDD VSS NOR200
X_1183_ net73 _0255_ _0550_ _0551_ VDD VSS ADNR01
X_1184_ _0546_ _0549_ _0551_ _0552_ VSS VDD ORND01
X_1185_ net73 _0255_ _0553_ VDD VSS NOR200
X_1186_ _0250_ u_pwm.u_pwm_core.duty_active[63] _0553_ _0554_ VDD VSS ADNR01
X_1187_ _0250_ u_pwm.u_pwm_core.duty_active[63] net374 _0555_ VSS VDD ORND01
X_1188_ _0552_ _0554_ _0555_ u_pwm.u_pwm_core.pwm_next[7] VDD VSS ADNR01
X_1189_ u_pwm.u_pwm_core.prescale_count[7] _0234_ _0556_ VDD VSS NOR200
X_1190_ _0235_ u_pwm.prescaler[6] _0557_ VSS VDD NND201
X_1191_ u_pwm.u_pwm_core.prescale_count[5] _0236_ _0558_ VSS VDD NND201
X_1192_ _0240_ u_pwm.prescaler[1] _0559_ VDD VSS NOR200
X_1193_ _0238_ u_pwm.prescaler[3] _0560_ VSS VDD NND201
X_1194_ _0239_ u_pwm.prescaler[2] _0561_ VDD VSS NOR200
X_1195_ _0240_ u_pwm.prescaler[1] _0241_ u_pwm.prescaler[0] _0562_ VDD VSS AOI401
X_1196_ u_pwm.u_pwm_core.prescale_count[2] u_pwm.prescaler[2] _0563_ VSS VDD XOR201
X_1197_ _0238_ u_pwm.prescaler[3] _0563_ _0564_ VDD VSS ADNR01
X_1198_ _0559_ _0562_ _0564_ _0565_ VSS VDD ORND01
X_1199_ _0238_ u_pwm.prescaler[3] _0566_ VDD VSS NOR200
X_1200_ u_pwm.u_pwm_core.prescale_count[4] _0237_ _0567_ VSS VDD NND201
X_1201_ _0560_ _0561_ _0566_ _0568_ VDD VSS ADNR01
X_1202_ _0568_ _0567_ _0565_ _0569_ VDD VSS AND301
X_1203_ u_pwm.u_pwm_core.prescale_count[5] _0236_ _0570_ VDD VSS NOR200
X_1204_ u_pwm.u_pwm_core.prescale_count[4] _0237_ _0571_ VDD VSS NOR200
X_1205_ _0570_ _0571_ _0572_ VSS VDD OR2101
X_1206_ _0569_ _0572_ _0558_ _0573_ VSS VDD ORND01
X_1207_ u_pwm.u_pwm_core.prescale_count[7] _0234_ _0574_ VSS VDD NND201
X_1208_ _0235_ u_pwm.prescaler[6] _0574_ _0575_ VSS VDD ORND01
X_1209_ _0557_ _0573_ _0575_ _0576_ VDD VSS ADNR01
X_1210_ _0556_ _0576_ _0577_ VDD VSS NOR200
X_1211_ net72 _0577_ _0578_ VSS VDD OR2101
X_1212_ u_pwm.u_pwm_core.prescale_count[0] _0578_ _0000_ VDD VSS NOR200
X_1213_ _0240_ _0241_ _0579_ VDD VSS NOR200
X_1214_ u_pwm.u_pwm_core.prescale_count[1] u_pwm.u_pwm_core.prescale_count[0] _0580_ VDD VSS NOR200
X_1215_ _0578_ _0579_ _0580_ _0001_ VDD VSS NOR300
X_1216_ _0239_ _0240_ _0241_ _0581_ VDD VSS NOR300
X_1217_ u_pwm.u_pwm_core.prescale_count[2] _0579_ _0582_ VDD VSS NOR200
X_1218_ _0578_ _0581_ _0582_ _0002_ VDD VSS NOR300
X_1219_ u_pwm.u_pwm_core.prescale_count[3] _0581_ _0583_ VSS VDD AND201
X_1220_ u_pwm.u_pwm_core.prescale_count[3] _0581_ _0584_ VDD VSS NOR200
X_1221_ _0578_ _0583_ _0584_ _0003_ VDD VSS NOR300
X_1222_ u_pwm.u_pwm_core.prescale_count[4] _0583_ _0585_ VSS VDD AND201
X_1223_ u_pwm.u_pwm_core.prescale_count[4] _0583_ _0586_ VDD VSS NOR200
X_1224_ _0578_ _0585_ _0586_ _0004_ VDD VSS NOR300
X_1225_ u_pwm.u_pwm_core.prescale_count[5] _0585_ _0587_ VSS VDD AND201
X_1226_ u_pwm.u_pwm_core.prescale_count[5] _0585_ _0588_ VDD VSS NOR200
X_1227_ _0578_ _0587_ _0588_ _0005_ VDD VSS NOR300
X_1228_ u_pwm.u_pwm_core.prescale_count[6] _0587_ _0589_ VSS VDD AND201
X_1229_ u_pwm.u_pwm_core.prescale_count[6] _0587_ _0590_ VDD VSS NOR200
X_1230_ _0578_ _0589_ _0590_ _0006_ VDD VSS NOR300
X_1231_ u_pwm.u_pwm_core.prescale_count[7] _0589_ _0591_ VSS VDD XNR201
X_1232_ _0578_ _0591_ _0007_ VDD VSS NOR200
X_1233_ u_pwm.u_spi.bit_cnt[0] u_pwm.u_spi.bit_cnt[1] _0592_ VSS VDD AND201
X_1234_ _0260_ _0592_ _0629_[1] VDD VSS NOR200
X_1235_ u_pwm.u_spi.bit_cnt[2] _0592_ _0593_ VSS VDD NND201
X_1236_ u_pwm.u_spi.bit_cnt[2] _0592_ _0629_[2] VSS VDD XOR201
X_1237_ u_pwm.u_spi.bit_cnt[3] _0593_ _0629_[3] VSS VDD XNR201
X_1238_ u_pwm.pwm_en u_pwm.u_pwm_core.wrap _0008_ VSS VDD AND201
X_1239_ u_pwm.u_pwm_core.phase[1] u_pwm.u_pwm_core.phase[0] _0594_ VSS VDD NND201
X_1240_ u_pwm.u_pwm_core.phase[3] u_pwm.u_pwm_core.phase[2] _0595_ VSS VDD NND201
X_1241_ _0244_ _0556_ _0576_ _0596_ VDD VSS NOR300
X_1242_ _0594_ _0556_ _0576_ _0597_ VDD VSS NOR301
X_1243_ _0597_ u_pwm.u_pwm_core.phase[2] u_pwm.u_pwm_core.phase[3] _0598_ VDD VSS AND301
X_1244_ _0595_ _0594_ _0576_ _0556_ _0248_ _0599_ VDD VSS NOR501
X_1245_ u_pwm.u_pwm_core.phase[5] _0599_ _0600_ VSS VDD AND201
X_1246_ _0599_ u_pwm.u_pwm_core.phase[6] u_pwm.u_pwm_core.phase[5] _0011_ VDD VSS AND301
X_1247_ _0011_ _0601_ VDD VSS INVR01
X_1248_ _0242_ _0250_ _0601_ _0009_ VDD VSS NOR300
X_1249_ u_pwm.u_reg_bank.wr_addr[1] u_pwm.u_reg_bank.wr_addr[0] _0602_ VDD VSS NOR200
X_1250_ u_pwm.u_reg_bank.wr_addr[5] u_pwm.u_reg_bank.wr_addr[6] _0603_ VSS VDD OR2101
X_1251_ u_pwm.wr_toggle_seen u_pwm.u_wr_toggle_sync.sync_ff2 _0604_ VSS VDD XNR201
X_1252_ _0604_ u_pwm.u_reg_bank.wr_addr[4] _0603_ _0605_ VDD VSS NOR301
X_1253_ _0605_ _0606_ VDD VSS INVR01
X_1254_ _0602_ _0605_ _0607_ VSS VDD NND201
X_1255_ _0233_ u_pwm.u_reg_bank.wr_addr[3] _0608_ VSS VDD NND201
X_1256_ _0607_ _0608_ _0609_ VDD VSS NOR200
X_1257_ _0609_ net443 _0047_ net228 VDD VSS MX2101
X_1258_ net43 net441 _0048_ net216 VDD VSS MX2101
X_1259_ net43 net439 _0049_ net206 VDD VSS MX2101
X_1260_ net42 net437 _0050_ net191 VDD VSS MX2101
X_1261_ net42 net435 _0051_ net177 VDD VSS MX2101
X_1262_ net42 net433 _0052_ net160 VDD VSS MX2101
X_1263_ net42 net431 _0053_ net144 VDD VSS MX2101
X_1264_ net42 net428 _0054_ net130 VDD VSS MX2101
X_1265_ _0250_ _0601_ net375 _0610_ VSS VDD ORND01
X_1266_ net3 u_pwm.u_pwm_core.duty_active[0] _0055_ net337 VDD VSS MX2101
X_1267_ net3 net427 _0056_ net335 VDD VSS MX2101
X_1268_ net2 net426 _0057_ u_pwm.duty[2] VDD VSS MX2101
X_1269_ net9 net425 _0058_ net333 VDD VSS MX2101
X_1270_ net9 net424 _0059_ net331 VDD VSS MX2101
X_1271_ net10 net423 _0060_ net328 VDD VSS MX2101
X_1272_ net10 net422 _0061_ net326 VDD VSS MX2101
X_1273_ net10 net421 _0062_ net325 VDD VSS MX2101
X_1274_ net2 u_pwm.u_pwm_core.duty_active[8] _0063_ u_pwm.duty[8] VDD VSS MX2101
X_1275_ net2 net420 _0064_ net322 VDD VSS MX2101
X_1276_ net2 net419 _0065_ net320 VDD VSS MX2101
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
X_1352_ net38 net170 _0133_ net353 VDD VSS MX2101
X_1353_ net38 net155 _0134_ net352 VDD VSS MX2101
X_1354_ net38 net141 _0135_ u_pwm.prescaler[7] VDD VSS MX2101
X_1355_ _0613_ _0616_ _0619_ VDD VSS NOR201
X_1356_ net36 net351 _0136_ net236 VDD VSS MX2101
X_1357_ _0619_ net350 _0137_ net221 VDD VSS MX2101
X_1358_ net37 net348 _0138_ net211 VDD VSS MX2101
X_1359_ net37 net346 _0139_ net198 VDD VSS MX2101
X_1360_ net36 u_pwm.duty[28] _0140_ net182 VDD VSS MX2101
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
