ayush130305/8-Channel-PWM-Controller-with-SPI-Interface/pnr/libtest/libtest_pwr.v

module libtest (clk,
    in0,
    in1,
    in2,
    in3,
    in4,
    in5,
    out0,
    out1,
    out2,
    out3,
    out4,
    out5,
    out6,
    out7,
    rst_n);
 input clk;
 input in0;
 input in1;
 input in2;
 input in3;
 input in4;
 input in5;
 output out0;
 output out1;
 output out2;
 output out3;
 output out4;
 output out5;
 output out6;
 output out7;
 input rst_n;

 wire n0;
 wire n1;
 wire n10;
 wire n100;
 wire n101;
 wire n102;
 wire n103;
 wire n104;
 wire n105;
 wire n106;
 wire n107;
 wire n108;
 wire n109;
 wire n11;
 wire n110;
 wire n111;
 wire n112;
 wire n113;
 wire n114;
 wire n115;
 wire n116;
 wire n117;
 wire n118;
 wire n119;
 wire n12;
 wire n120;
 wire n121;
 wire n122;
 wire n123;
 wire n124;
 wire n125;
 wire n126;
 wire n127;
 wire n128;
 wire n129;
 wire n13;
 wire n130;
 wire n131;
 wire n132;
 wire n133;
 wire n134;
 wire n135;
 wire n136;
 wire n137;
 wire n138;
 wire n139;
 wire n14;
 wire n140;
 wire n141;
 wire n142;
 wire n143;
 wire n144;
 wire n145;
 wire n146;
 wire n147;
 wire n148;
 wire n149;
 wire n15;
 wire n150;
 wire n151;
 wire n152;
 wire n153;
 wire n154;
 wire n155;
 wire n156;
 wire n157;
 wire n158;
 wire n159;
 wire n16;
 wire n160;
 wire n161;
 wire n162;
 wire n163;
 wire n164;
 wire n165;
 wire n166;
 wire n167;
 wire n168;
 wire n169;
 wire n17;
 wire n170;
 wire n171;
 wire n172;
 wire n173;
 wire n174;
 wire n175;
 wire n176;
 wire n177;
 wire n178;
 wire n179;
 wire n18;
 wire n180;
 wire n181;
 wire n182;
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
    .QB(n107),
    .VSS(VSS),
    .CLRB(rst_n),
    .VDD(VDD));
 CDRI01 clkbuf_0_clk (.Q(clknet_0_clk),
    .IN1(clk));
 CDRI01 clkbuf_1_0__f_clk (.Q(clknet_1_0__leaf_clk),
    .IN1(clknet_0_clk));
 CDRI01 clkbuf_1_1__f_clk (.Q(clknet_1_1__leaf_clk),
    .IN1(clknet_0_clk));
endmodule
