ayush130305/8-Channel-PWM-Controller-with-SPI-Interface/(commit log)

2026-11-13 pwm8-spi (OS0097): 8-channel PWM controller with SPI on SCL 1.2 um C1D
    RTL, testbenches, synthesis, place-and-route, sign-off, DRC/LVS reports and
    images for the taped-out pwm8-spi chip. SCL-owned and SCL-derived data
    (PDK views, GDS with SCL cells, submission paperwork) are excluded.
    [offgrid_points_v1.csv, pwm8_spi_core_max.sdf, pwm8_spi_core_min.sdf, pwm8_spi_core_typ.sdf]
2026-11-13 README: add die/core/cell area, transistor count and what 1.2 um means
